Alexey-Tsarev/Water_Leak_Guard/schema/main.sch

## EAGLE design schema/main.sch (2017-04-11)

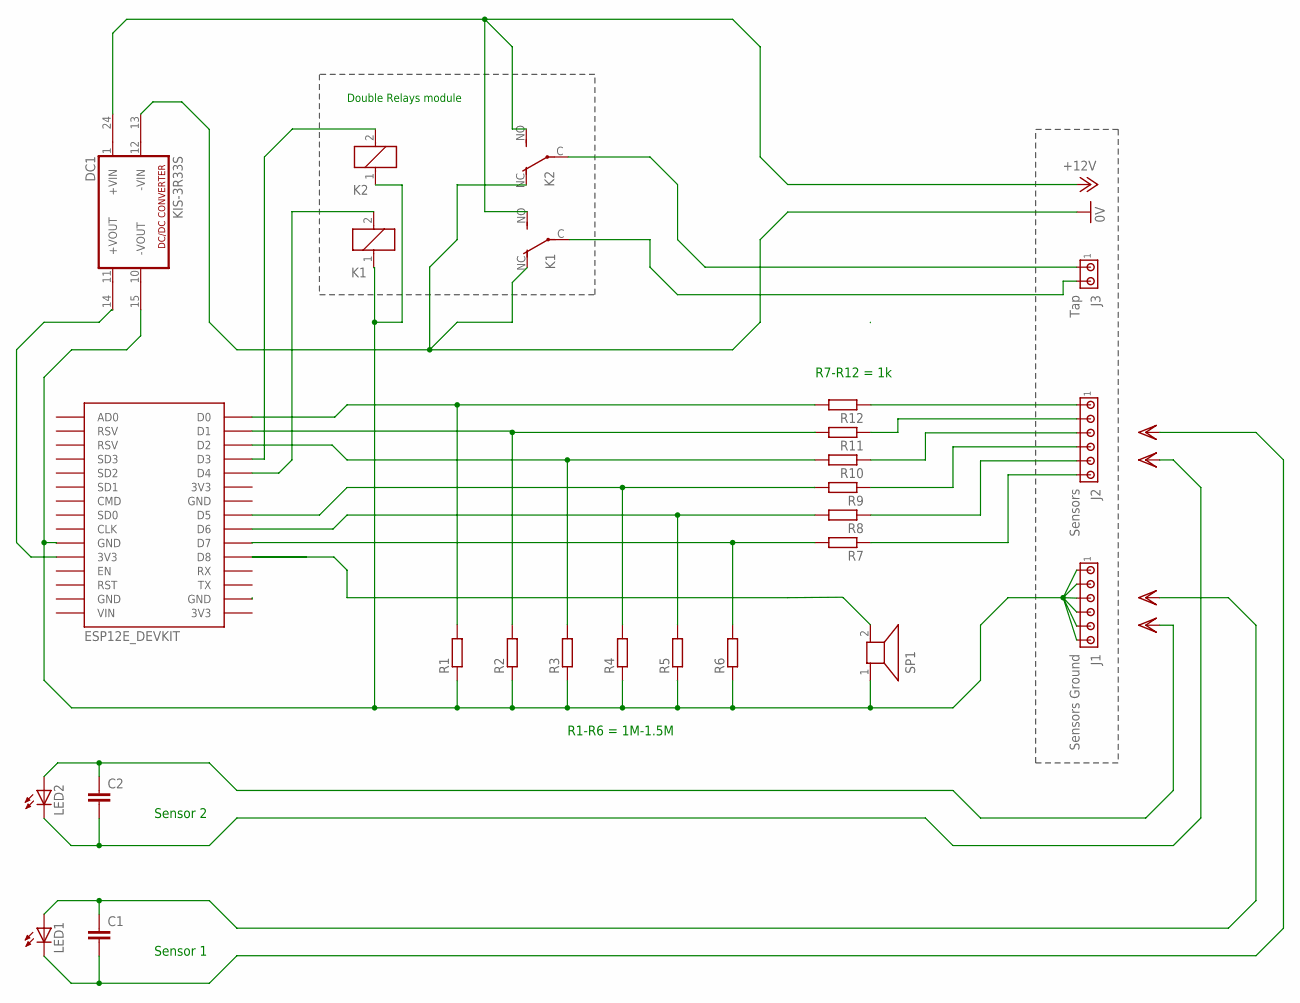
[picture p1: schematic main.sch]

Parts:
C1, C2: C2,5-3; C2.5-3
DC1: KIS-3R33S; CMK
J1: Sensors Ground; 1X6MTA
J2: Sensors; 1X6MTA
J3: Tap; 1X2MTA
K1, K2: CT112; CT-SLIM
LED1, LED2: TLLG4400; LED3MM
R1, R2, R3, R4, R5, R6, R7, R8, R9, R10, R11, R12: R-EU_0204/7; 0204/7
SP1: AL30P
U$1: ESP12E_DEVKIT

Connections:
0V: DC1.13 (-VIN1), K1.NC (O), K2.NC (O)
+12V: DC1.24 (+VIN1), K1.NO (S), K2.NO (S)
unnamed: J2.6, R7.1
unnamed: R1.2, R12.2, U$1.D0
unnamed: R2.2, R11.2, U$1.D1
unnamed: R3.2, R10.2, U$1.D2
unnamed: R4.2, R9.2, U$1.D5
unnamed: R5.2, R8.2, U$1.D6
unnamed: R6.2, R7.2, U$1.D7
unnamed: K2.2, U$1.D3
unnamed: J2.1, R12.1
unnamed: J3.2, K1.C
unnamed: J3.1, K2.C
unnamed: J2.2, R11.1
unnamed: J2.3, R10.1
unnamed: J2.5, R8.1
unnamed: J2.4, R9.1
unnamed: DC1.15 (-VOUT1), J1.1, J1.2, J1.3, J1.4, J1.5, J1.6, K1.1, K2.1, R1.1, R2.1, R3.1, R4.1, R5.1, R6.1, SP1.1, U$1.GND@0 (GND)
unnamed: K1.2, U$1.D4
unnamed: DC1.14 (+VOUT1), U$1.3V3@0 (3V3)
VDD: C1.2, C2.2, LED1.K (C), LED2.K (C)
VSS: C1.1, C2.1, LED1.A, LED2.A

Notes on the sheet:
Double Relays module
R1-R6 = 1M-1.5M
R7-R12 = 1k
Sensor 1
Sensor 2
